joeribraams/TeensyPedal/PCB/TeensyPedal.brd

## EAGLE design PCB/TeensyPedal.brd (2020-12-22)

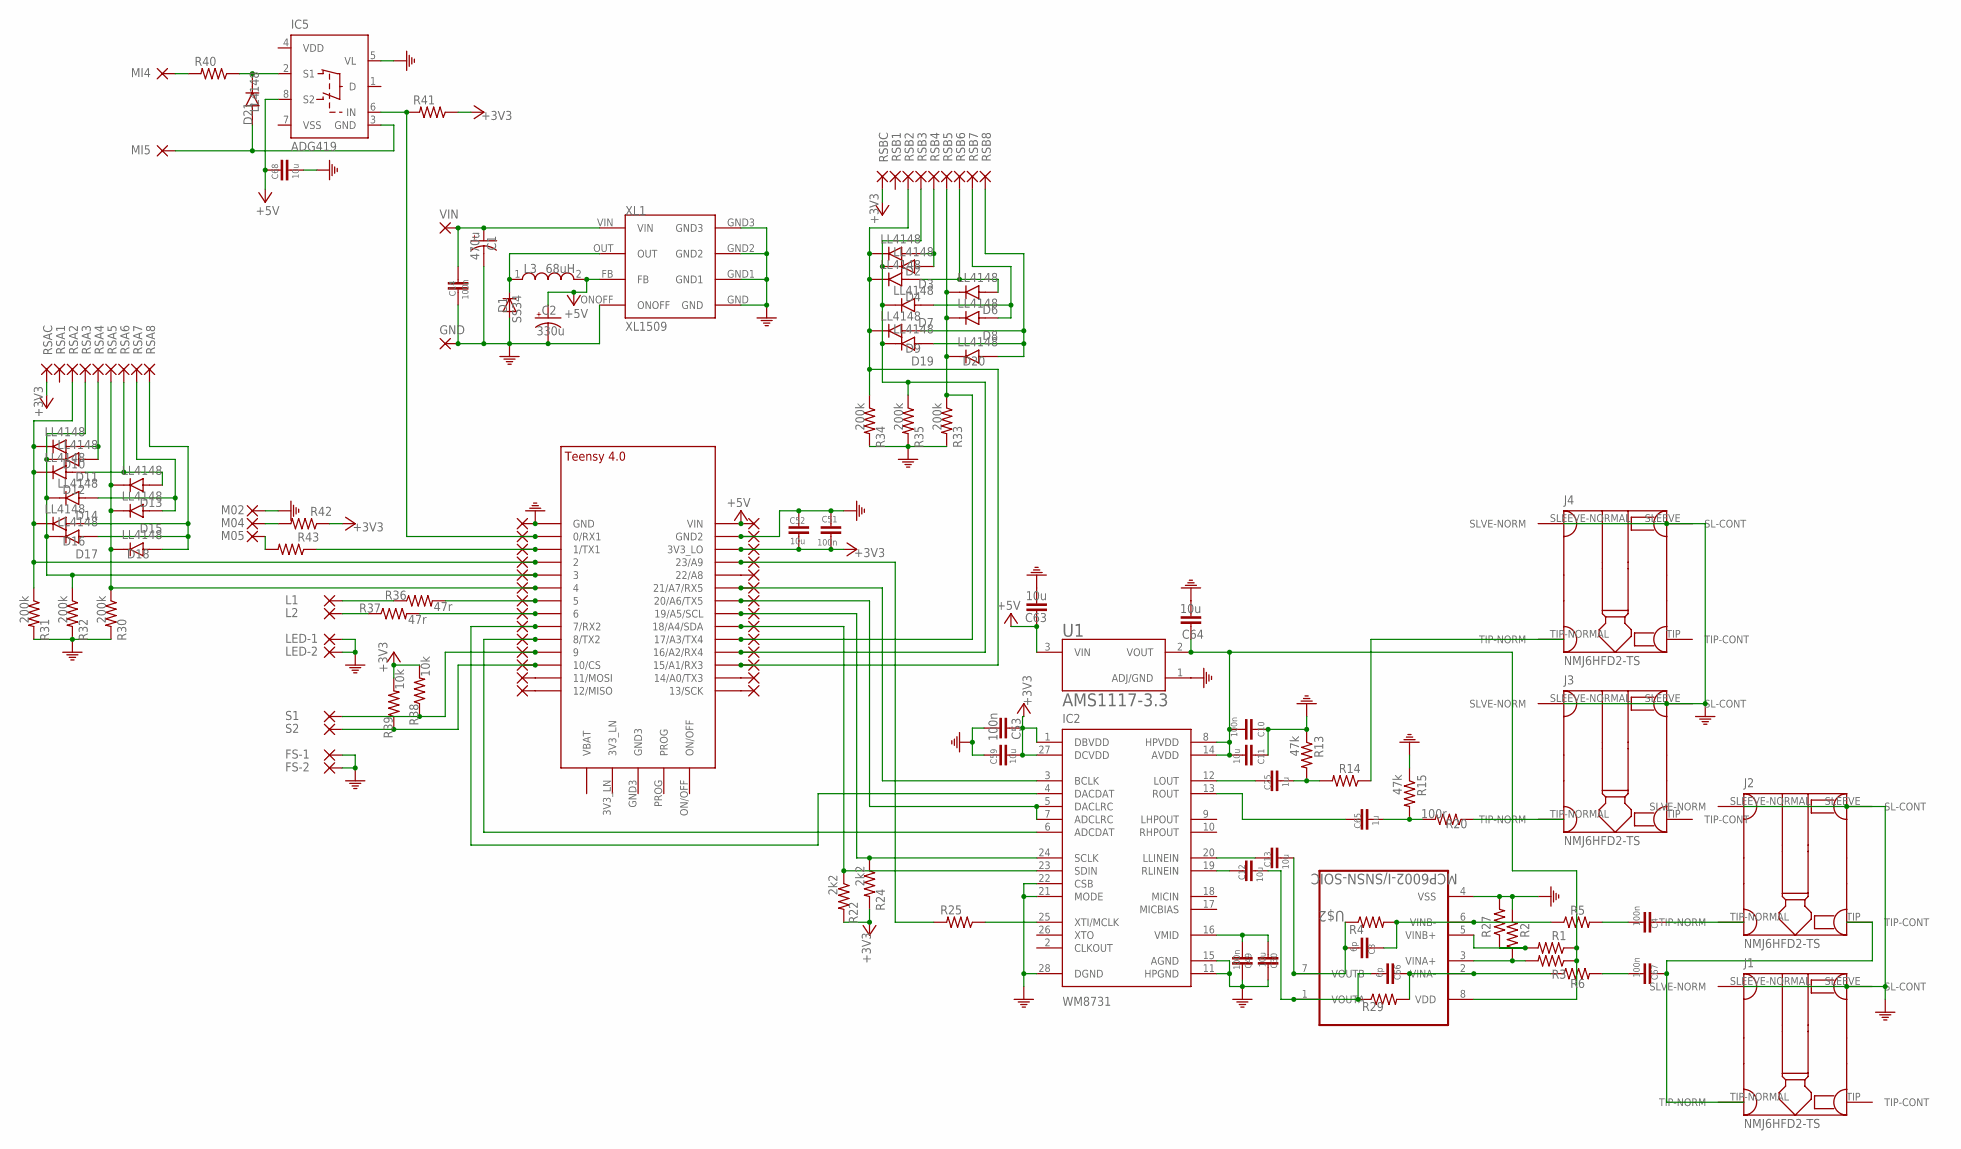
[picture p1: schematic TeensyPedal.sch]

Parts:
+5V: 1,6/0,9
C1: 470u; B45181B
C2: 330u; B45181B
C3, C66: 6p; C0603
C4, C10, C14, C49, C51, C53, C67: 100n; C0603
C11, C12, C13, C30, C52, C59, C63, C64, C68: 10u; C0805
C25, C65: 1u; C0603
D1: SS34; DO214AC
D2, D3, D4, D6, D7, D8, D9, D10, D11, D12, D13, D14, D15, D16, D17, D18, D19, D20, D21: LL4148; DIO_LL4148
FS-1, FS-2: 1,6/0,9
GND: 1,6/0,9
GND10: 2,15/1,0
IC2: WM8731; SSOP28
IC5: ADG419; DIL08
J1, J2, J3, J4: NMJ6HFD2-TS
L1, L2: 1,6/0,9
L3: 68uH; WE-PD_1260/1245/1280/1210
LED-1, LED-2: 1,6/0,9
M02, M04, M05: 2,15/1,0
MI4, MI5: 2,15/1,0
PIN, PIN1, PIN2, PIN3, PIN4, PIN5, PIN6, PIN7, PIN8, PIN9, PIN10, PIN11, PIN12, PIN13, PIN14, PIN15, PIN16, PIN17, PIN18, PIN19, PIN20, PIN21, PIN22, PIN23, PIN24, PIN25: 1,6/0,9
R1, R2, R3, R27, R30, R31, R32, R33, R34, R35: 200k; R0603
R4, R29: 1m; 0204/7
R5, R6: 1m; R0603
R13, R15: 47k; R0603
R14, R20: 100r; R0603
R22, R24: 2k2; R0603
R25, R40: 220r; R0603
R36, R37, R42, R43: 47r; R0603
R38, R39: 10k; R0603
R41: 470r; R0603
RSA1, RSA2, RSA3, RSA4, RSA5, RSA6, RSA7, RSA8: 2,15/1,0
RSAC: 2,15/1,0
RSB1: 2,54/1,1
RSB2, RSB3, RSB4, RSB5, RSB6, RSB7, RSB8: 2,15/1,0
RSBC: 2,15/1,0
S1, S2: 1,6/0,9
U1: AMS1117-3.3; SOT229P700X180-4N
U$1: TEENSY_4.0
U$2: MCP6002-I/SNSN-SOIC; SOIC127P690X150-8N
VIN: 2,15/1,0
XL1: XL1509

Connections:
3V3_ANA1: C10.1, C11.1, C64.1, IC2.8 (HPVDD), IC2.14 (AVDD), R1.1, R3.1, U1.2 (VOUT), U$2.8 (VDD)
+3V3: C51.1, C52.2, C53.1, C59.2, IC2.1 (DBVDD), IC2.27 (DCVDD), PIN24.1, R22.2, R24.2, R38.2, R39.2, R41.1, R42.1, RSAC.1, RSBC.1, U$1.3V3_LO
+5V: +5V.1, C2.+, C63.1, C68.1, IC5.8 (S2), L3.2, U1.3 (VIN), U$1.VIN, XL1.FB
unnamed: D1.C, L3.1, XL1.OUT
unnamed: C30.2, C49.2, IC2.16 (VMID)
unnamed: IC2.24 (SCLK), PIN19.1, R24.1, U$1.19/A5/SCL
unnamed: IC2.23 (SDIN), PIN18.1, R22.1, U$1.18/A4/SDA
unnamed: C4.2, J2.TIP-NORMAL (TIP-NORM)
unnamed: R1.2, R27.1, U$2.5 (VINB+)
unnamed: C4.1, R5.2
unnamed: C12.1, C66.1, R29.1, U$2.1 (VOUTA)
unnamed: R2.1, R3.2, U$2.3 (VINA+)
unnamed: C3.2, R4.2, R5.1, U$2.6 (VINB-)
unnamed: C66.2, R6.1, R29.2, U$2.2 (VINA-)
unnamed: C3.1, C13.1, R4.1, U$2.7 (VOUTB)
unnamed: C67.1, R6.2
unnamed: C67.2, J1.TIP-NORMAL (TIP-NORM), J2.TIP (TIP-CONT)
unnamed: PIN13.1, U$1.13/SCK
unnamed: IC2.5 (DACLRC), IC2.7 (ADCLRC), PIN20.1, U$1.20/A6 (20/A6/TX5)
unnamed: PIN14.1, U$1.14/A0 (14/A0/TX3)
unnamed: C25.1, R13.2, R14.2
unnamed: C25.2, IC2.12 (LOUT)
unnamed: J4.TIP-NORMAL (TIP-NORM), R14.1
unnamed: C65.1, R15.2, R20.2
unnamed: J3.TIP-NORMAL (TIP-NORM), R20.1
unnamed: C65.2, IC2.13 (ROUT)
unnamed: IC2.4 (DACDAT), PIN7.1, U$1.7 (7/RX2)
unnamed: IC2.6 (ADCDAT), PIN8.1, U$1.8 (8/TX2)
unnamed: IC2.3 (BCLK), PIN21.1, U$1.21/A7 (21/A7/RX5)
unnamed: PIN23.1, R25.2, U$1.23/A9
unnamed: IC2.25 (XTI/MCLK), R25.1
unnamed: C13.2, IC2.20 (LLINEIN)
unnamed: D10.A, D11.A, RSA4.1
unnamed: C12.2, IC2.19 (RLINEIN)
unnamed: D12.A, D13.A, RSA6.1
unnamed: D14.A, D15.A, RSA7.1
unnamed: D16.A, D17.A, D18.A, RSA8.1
unnamed: IC5.6 (IN), PIN.1, R41.2, U$1.0/RX (0/RX1)
unnamed: PIN1.1, R43.1, U$1.1/TX (1/TX1)
unnamed: PIN5.1, R36.2, U$1.5
unnamed: PIN6.1, R37.2, U$1.6
unnamed: D21.C, IC5.2 (S1), R40.1
unnamed: D21.A, IC5.3 (GND), MI5.1
unnamed: PIN11.1, U$1.11/MOSI
unnamed: PIN12.1, U$1.12/MISO
unnamed: L1.1, R36.1
unnamed: L2.1, R37.1
unnamed: MI4.1, R40.2
unnamed: PIN22.1, U$1.22/A8
unnamed: D2.A, D3.A, RSB4.1
unnamed: D4.A, D6.A, RSB6.1
unnamed: D7.A, D8.A, RSB7.1
unnamed: D9.A, D19.A, D20.A, RSB8.1
unnamed: PIN9.1, R38.1, S1.1, U$1.9/CS (9)
unnamed: PIN10.1, R39.1, S2.1, U$1.10/CS
unnamed: M04.1, R42.2
unnamed: M05.1, R43.2
PE: C1.-, C2.-, C10.2, C11.2, C14.1, C30.1, C49.1, C51.2, C52.1, C53.2, C59.1, C63.2, C64.2, C68.2, D1.A, FS-1.1, FS-2.1, GND.1, GND10.1, IC2.11 (HPGND), IC2.15 (AGND), IC2.21 (MODE), IC2.22 (CSB), IC2.28 (DGND), IC5.5 (VL), J1.SLEEVE (SL-CONT), J1.SLEEVE-NORMAL (SLVE-NORM), J2.SLEEVE (SL-CONT), J2.SLEEVE-NORMAL (SLVE-NORM), J3.SLEEVE (SL-CONT), J3.SLEEVE-NORMAL (SLVE-NORM), J4.SLEEVE (SL-CONT), J4.SLEEVE-NORMAL (SLVE-NORM), LED-1.1, LED-2.1, M02.1, PIN25.1, R2.2, R13.1, R15.1, R27.2, R30.2, R31.2, R32.2, R33.2, R34.2, R35.2, U1.1 (ADJ/GND), U$1.GND, U$1.GND2, U$2.4 (VSS), XL1.GND, XL1.GND1, XL1.GND2, XL1.GND3, XL1.ONOFF
RSW1: D10.C, D12.C, D16.C, PIN2.1, R31.1, RSA2.1, U$1.2
RSW2: D11.C, D14.C, D17.C, PIN3.1, R32.1, RSA3.1, U$1.3/CANTX (3)
RSW3: D13.C, D15.C, D18.C, PIN4.1, R30.1, RSA5.1, U$1.4/CANRX (4)
RSW4: D6.C, D8.C, D20.C, PIN17.1, R33.1, RSB5.1, U$1.17/A3 (17/A3/TX4)
RSW5: D3.C, D7.C, D19.C, PIN16.1, R35.1, RSB3.1, U$1.16/A2 (16/A2/RX4)
RSW6: D2.C, D4.C, D9.C, PIN15.1, R34.1, RSB2.1, U$1.15/A1 (15/A1/RX3)
VDD: IC5.4 (VDD)
VIN: C1.+, C14.2, VIN.1, XL1.VIN
VSS: IC5.7 (VSS)

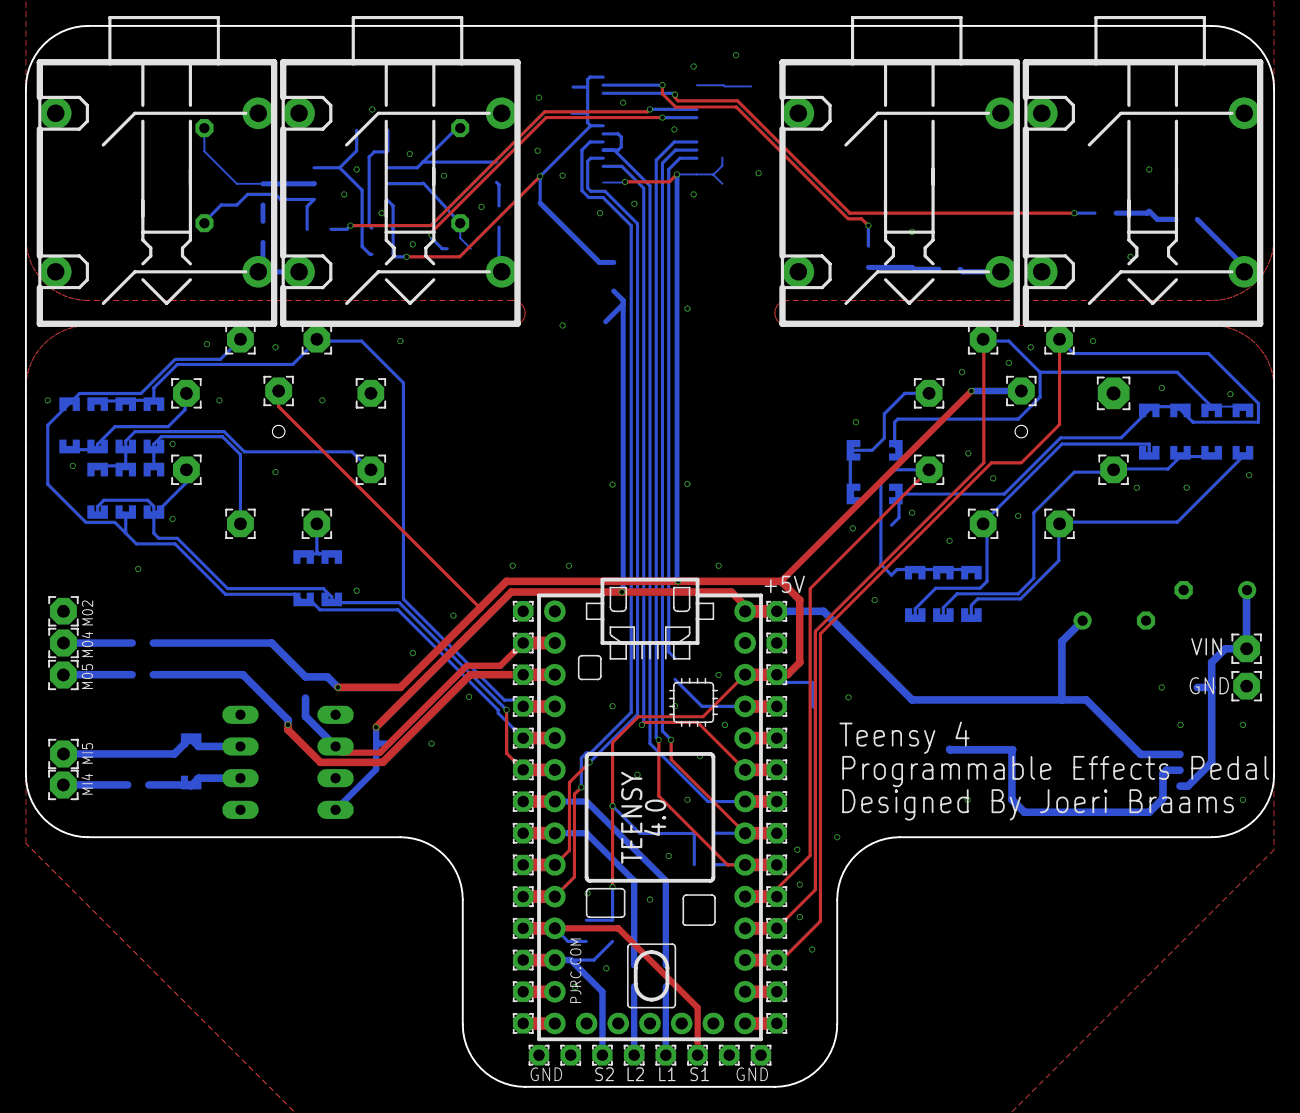
[picture p2: board TeensyPedal.brd from above]

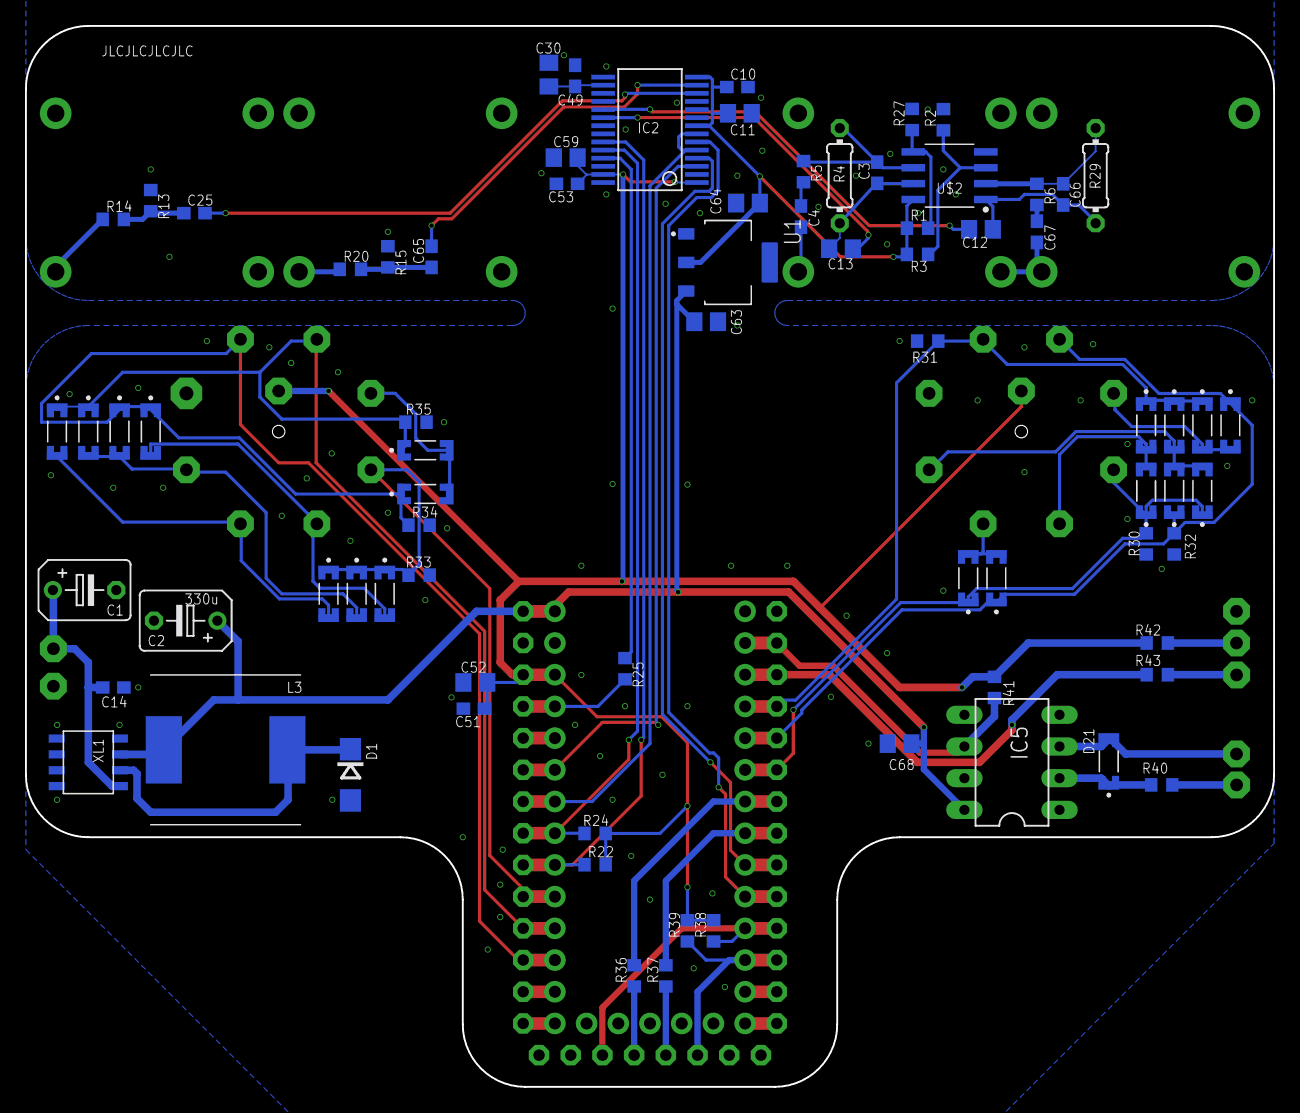
[picture p3: board TeensyPedal.brd from below]

Board: 2 copper layers, 100.0 x 85.0 mm, 143 parts (77 on the bottom side), 65 nets.
