joeribraams/TeensyPedal/(commit log)

2020-12-22 Initial Commit, (imperfect, but finished) PCB files and beginning of code
    [TeensyPedal.brd, TeensyPedal.sch, TeensyPedal_bottom_bom.csv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]
2020-12-26 Added USB audio, Added Reverse
    [FXFeedbacker.h, FXLooper.h, FXReverse.h, HCBiquad.h, HCTapTempo.h, TeensyPedal.ino]
