joeribraams/TeensyPedal/(notices)

Notices in the files:
parts and their libraries:
Wurth_Elektronik_Passive_rev15e: Copyright: Würth Elektronik
